ukkz/mokugyOS/img/cover.png

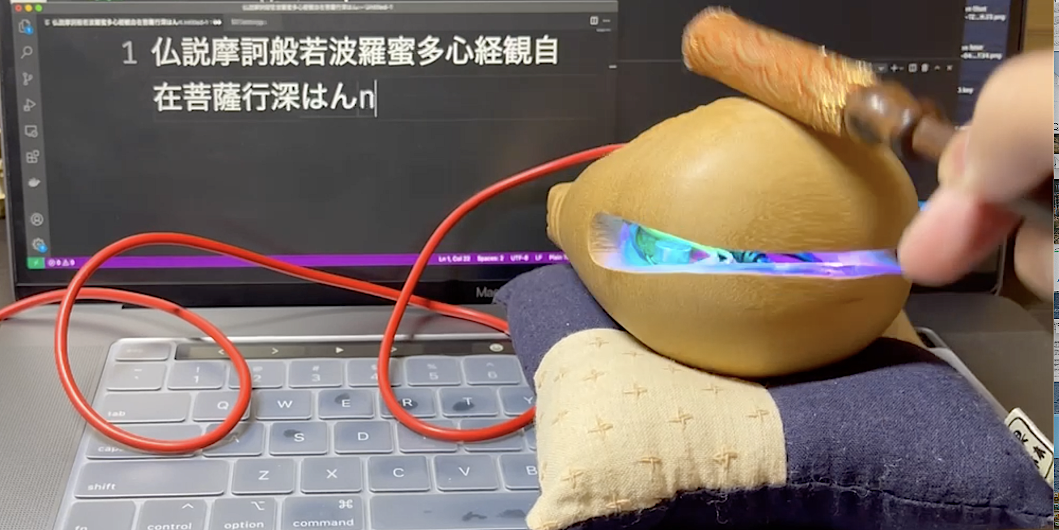
img/cover.png
