ukkz/mokugyOS/(commit log)

2021-05-29 日本語記事リンク追加
2023-11-07 カバーイメージ追加
2023-11-07 マイク実装有効化
